jknielse/NixieClock/NixieMicrocontrollerBoard/ArduinoPinMapping.txt

GPS:
8 - TX
9 - RX

SD:
1 - MISO
2 - SCK
3 - MOSI
4 - CS

Nixie:
5 - PROP
6 - CLK
7 - DATA
