jknielse/NixieClock/(list of files, drawings)

Other design files:
NixieDisplayBoard/NixieDisplayBoard.dsn
NixieDriverBoard/NixieDriverBoard.dsn
NixieMicrocontrollerBoard/NixieMicrocontrollerBoard.dsn
