jknielse/NixieClock/NixieMicrocontrollerBoard/NixieMicrocontrollerBoard.kicad_pcb

## KiCad design NixieMicrocontrollerBoard/NixieMicrocontrollerBoard.kicad_pcb (2016-02-14)

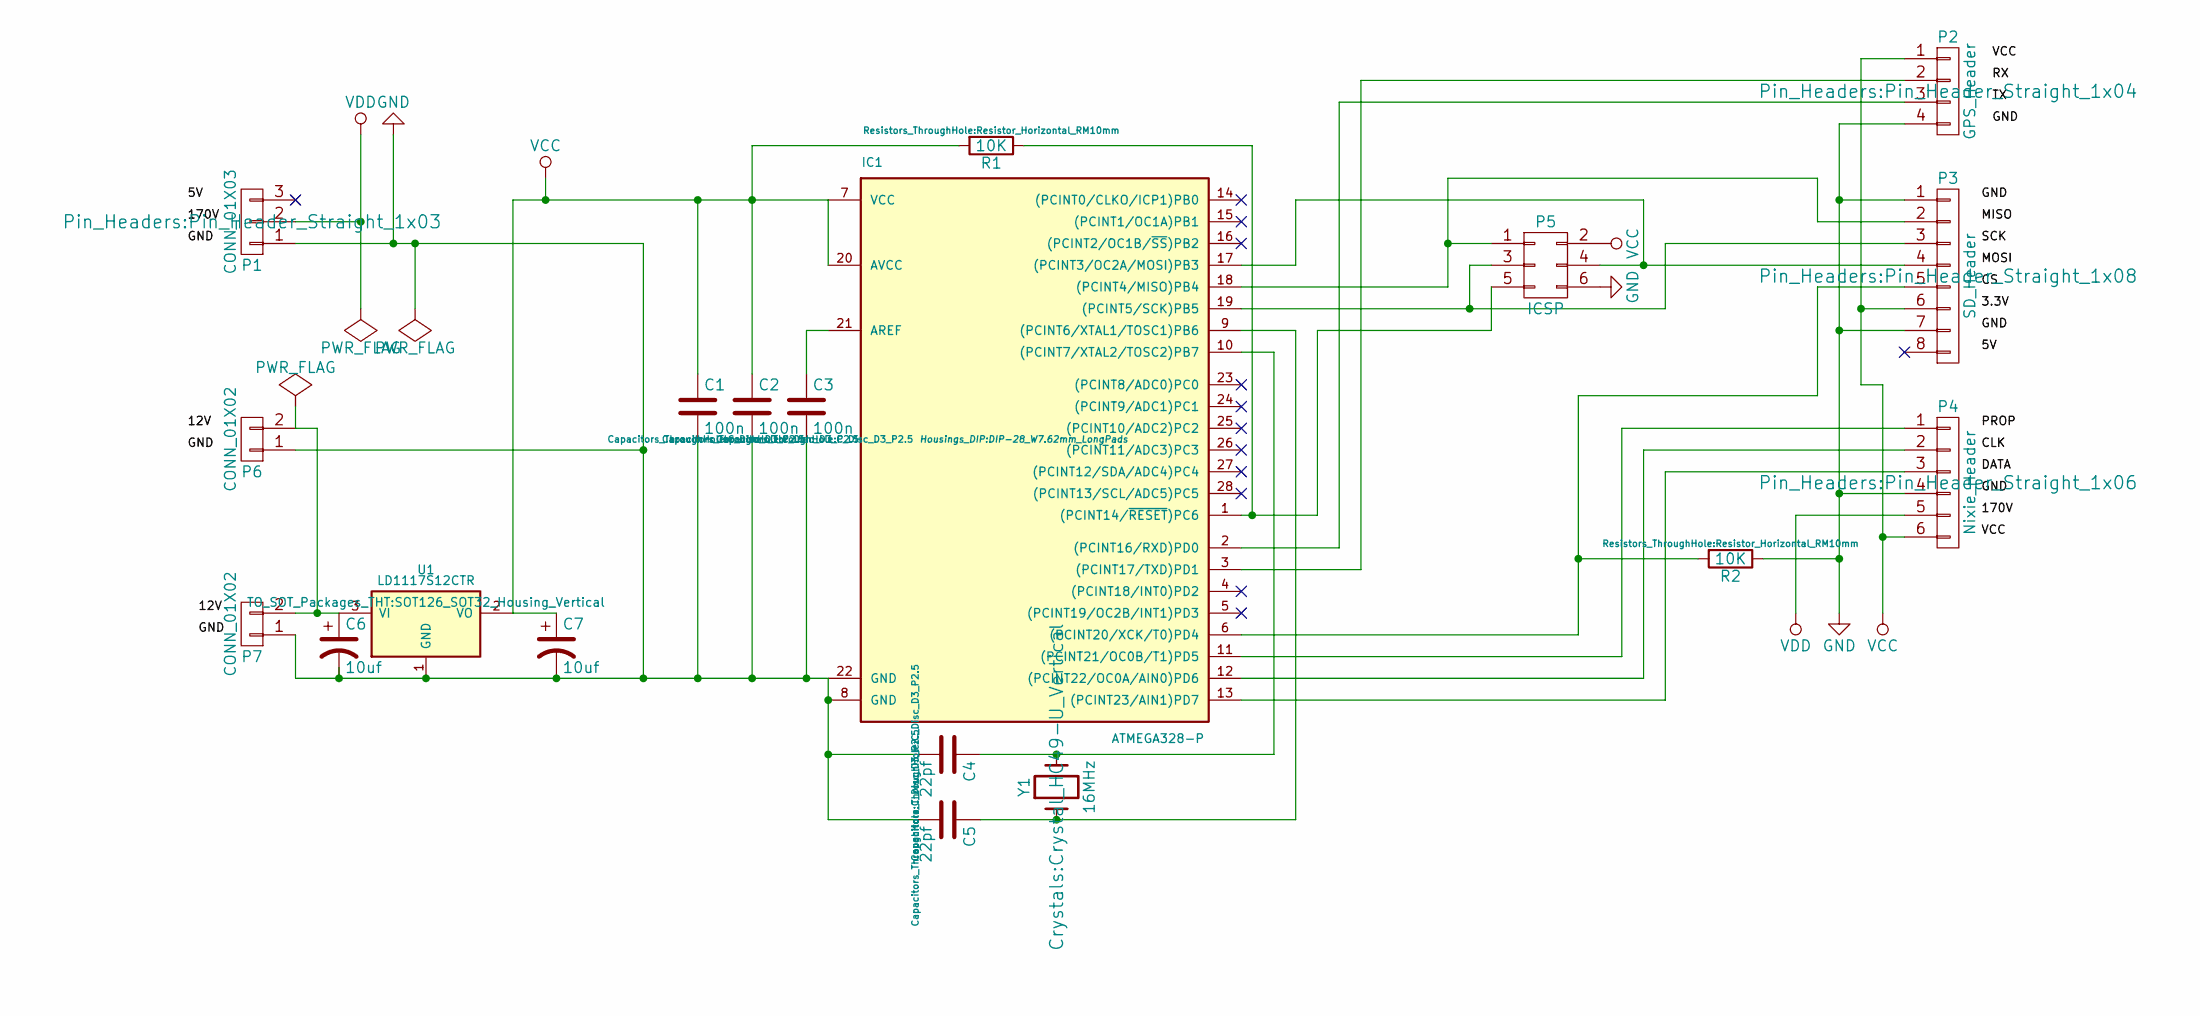
[picture p1: schematic NixieMicrocontrollerBoard.sch]

Parts:
C1, C2, C3: 100n; C_Disc_D3_P2.5
C4, C5: 22pf; C_Disc_D3_P2.5
C6, C7: 10uf; C_Radial_D5_L11_P2.5
IC1: ATMEGA328-P; DIP-28_W7.62mm_LongPads
P1: CONN_01X03; Pin_Header_Straight_1x03
P2: GPS_Header; Pin_Header_Straight_1x04
P3: SD_Header; Pin_Header_Straight_1x08
P4: Nixie_Header; Pin_Header_Straight_1x06
P5: ICSP; Pin_Header_Straight_2x03
P6, P7: CONN_01X02; Pin_Header_Straight_1x02
R1, R2: 10K; Resistor_Horizontal_RM10mm
U1: LD1117S12CTR; SOT126_SOT32_Housing_Vertical
Y1: 16MHz; Crystal_HC49-U_Vertical

Connections:
GND: C1.2, C2.2, C3.2, C4.2, C5.2, C6.2, C7.2, IC1.8 (GND), IC1.22 (GND), P1.1, P2.4, P3.1, P3.7, P4.4, P5.6, P6.1, P7.1, R2.1, U1.1 (GND)
unnamed: C3.1, IC1.21 (AREF)
unnamed: C4.1, IC1.10 ((PCINT7/XTAL2/TOSC2)PB7), Y1.2
unnamed: C5.1, IC1.9 ((PCINT6/XTAL1/TOSC1)PB6), Y1.1
unnamed: C6.1, P6.2, P7.2, U1.3 (VI)
unnamed: IC1.1 ((PCINT14/~RESET~)PC6), P5.5, R1.1
unnamed: IC1.2 ((PCINT16/RXD)PD0), P2.3
unnamed: IC1.3 ((PCINT17/TXD)PD1), P2.2
unnamed: IC1.6 ((PCINT20/XCK/T0)PD4), P3.5, R2.2
unnamed: IC1.11 ((PCINT21/OC0B/T1)PD5), P4.1
unnamed: IC1.12 ((PCINT22/OC0A/AIN0)PD6), P4.2
unnamed: IC1.13 ((PCINT23/AIN1)PD7), P4.3
unnamed: IC1.17 ((PCINT3/OC2A/MOSI)PB3), P3.4, P5.4
unnamed: IC1.18 ((PCINT4/MISO)PB4), P3.2, P5.1
unnamed: IC1.19 ((PCINT5/SCK)PB5), P3.3, P5.3
VCC: C1.1, C2.1, C7.1, IC1.7 (VCC), IC1.20 (AVCC), P2.1, P3.6, P4.6, P5.2, R1.2, U1.2 (VO)
VDD: P1.2, P4.5

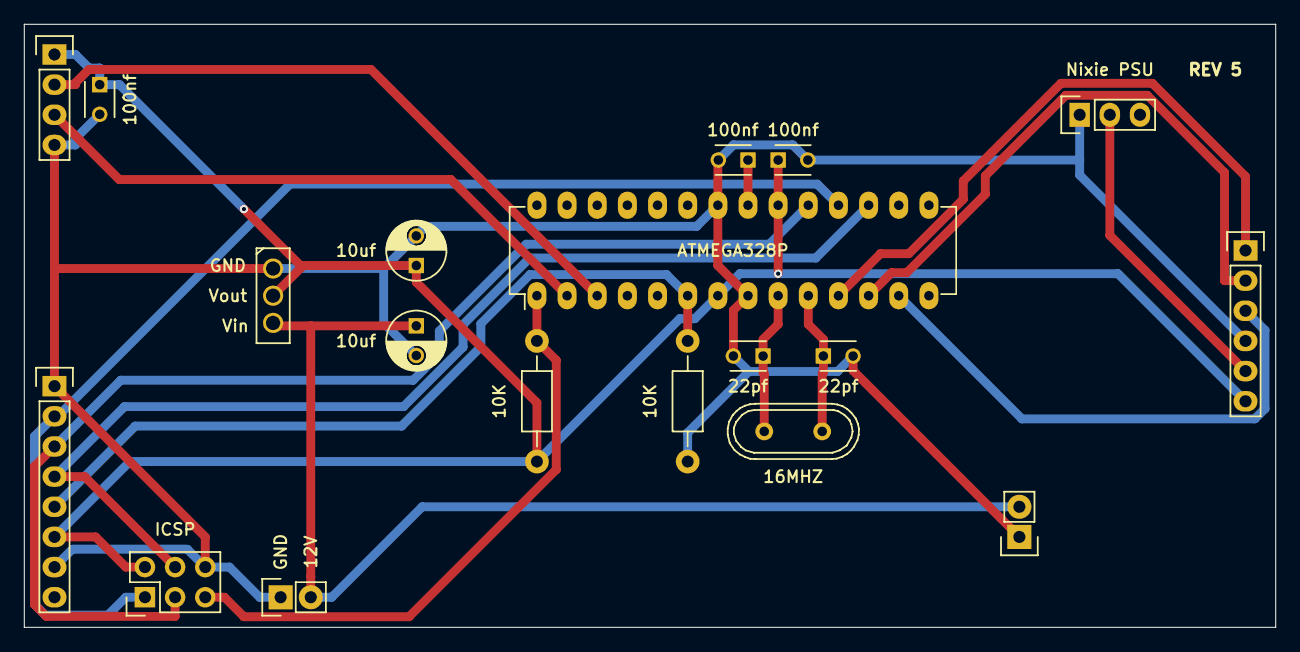
[picture p2: board NixieMicrocontrollerBoard.kicad_pcb from above]

Board: 2 copper layers, 105.4 x 50.8 mm, 19 parts (0 on the bottom side), 17 nets.
