jknielse/NixieClock/NixieDisplayBoard/NixieDisplayBoard.kicad_pcb

## KiCad design NixieDisplayBoard/NixieDisplayBoard.kicad_pcb (2015-11-25)

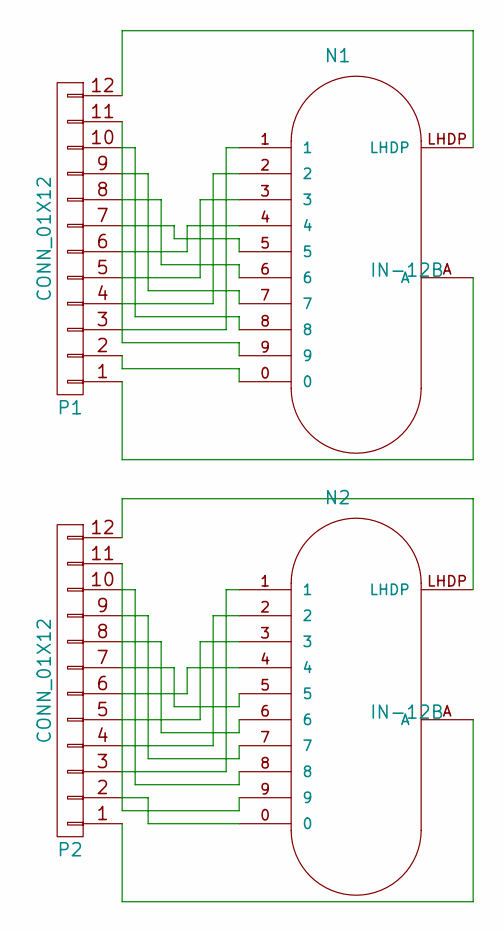
[picture p3: schematic NixieDisplayBoard.sch]

Parts:
N1, N2: IN-12B; russian-nixies-IN-12
P1, P2: CONN_01X12; Pin_Header_Straight_1x12

Connections:
unnamed: N1.0, P1.2
unnamed: N1.1, P1.3
unnamed: N1.2, P1.4
unnamed: N1.3, P1.5
unnamed: N1.4, P1.6
unnamed: N1.5, P1.7
unnamed: N1.6, P1.8
unnamed: N1.7, P1.9
unnamed: N1.8, P1.10
unnamed: N1.9, P1.11
unnamed: N1.A, P1.1
unnamed: N1.LHDP, P1.12
unnamed: N2.0, P2.2
unnamed: N2.1, P2.3
unnamed: N2.2, P2.4
unnamed: N2.3, P2.5
unnamed: N2.4, P2.6
unnamed: N2.5, P2.7
unnamed: N2.6, P2.8
unnamed: N2.7, P2.9
unnamed: N2.8, P2.10
unnamed: N2.9, P2.11
unnamed: N2.A, P2.1
unnamed: N2.LHDP, P2.12

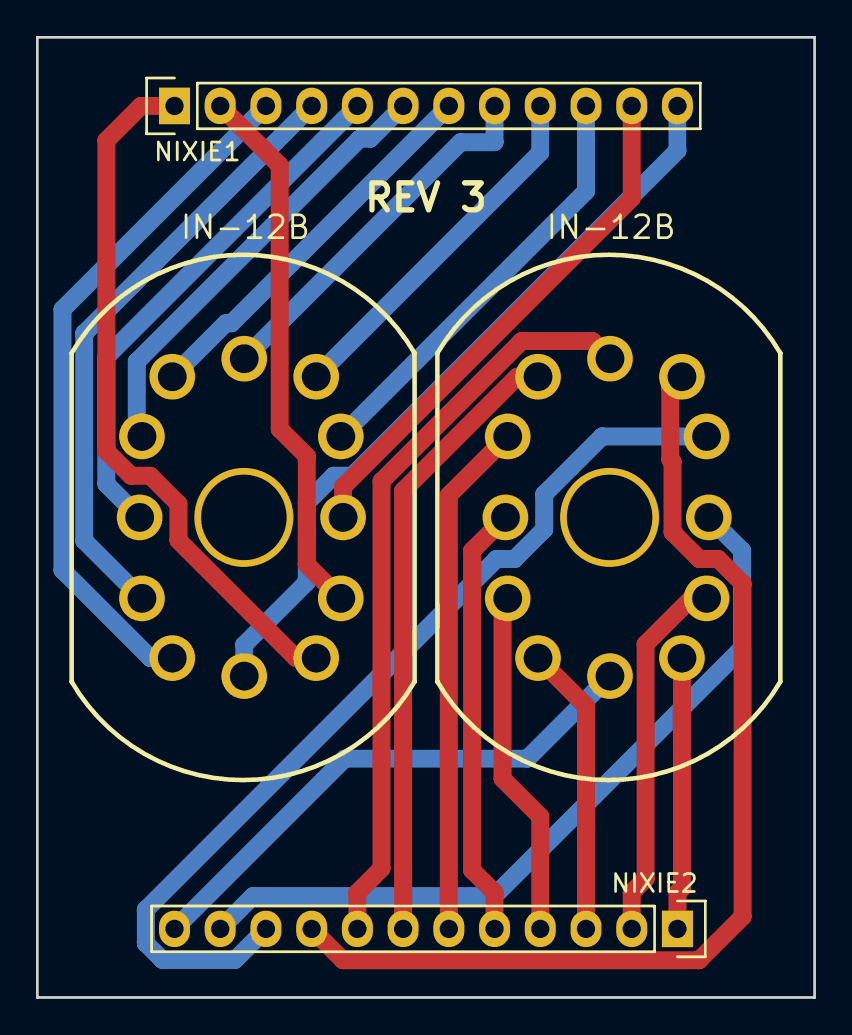
[picture p4: board NixieDisplayBoard.kicad_pcb from above]

Board: 2 copper layers, 43.2 x 53.3 mm, 4 parts (0 on the bottom side), 24 nets.
