jknielse/NixieClock/NixieDriverBoard/NixieDriverBoard.kicad_pcb

## KiCad design NixieDriverBoard/NixieDriverBoard.kicad_pcb (2015-11-25)

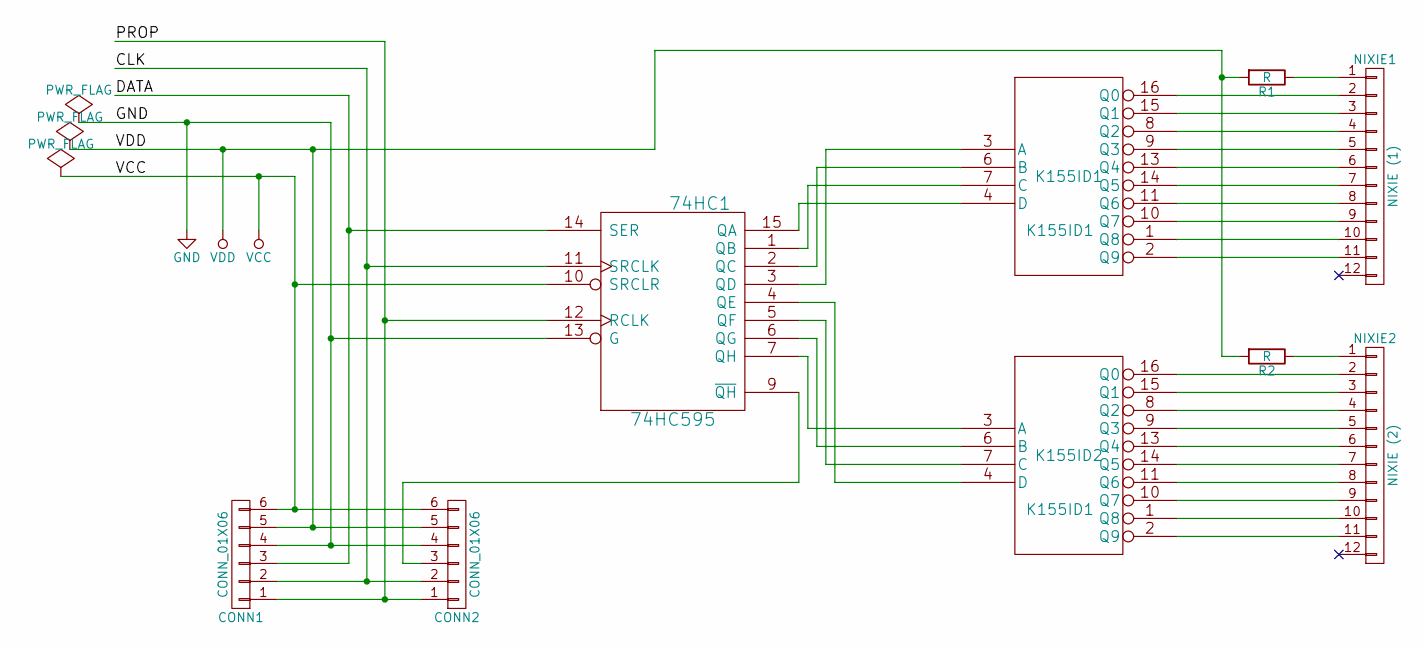
[picture p5: schematic NixieDriverBoard.sch]

Parts:
74HC1: 74HC595; DIP-16_W7.62mm_LongPads
CONN1, CONN2: CONN_01X06; Socket_Strip_Angled_1x06
K155ID1, K155ID2: K155ID1; DIP-16_W7.62mm_LongPads
NIXIE1: NIXIE (1); Socket_Strip_Straight_1x12
NIXIE2: NIXIE (2); Socket_Strip_Straight_1x12
R1, R2: R; Resistor_Horizontal_RM15mm

Connections:
/CLK: 74HC1.11 (SRCLK), CONN1.2, CONN2.2
/DATA: 74HC1.14 (SER), CONN1.3
/PROP: 74HC1.12 (RCLK), CONN1.1, CONN2.1
GND: 74HC1.8 (GND), 74HC1.13 (G), CONN1.4, CONN2.4, K155ID1.12 (GND), K155ID2.12 (GND)
unnamed: 74HC1.1 (QB), K155ID1.7 (C)
unnamed: 74HC1.2 (QC), K155ID1.6 (B)
unnamed: 74HC1.3 (QD), K155ID1.3 (A)
unnamed: 74HC1.4 (QE), K155ID2.4 (D)
unnamed: 74HC1.5 (QF), K155ID2.7 (C)
unnamed: 74HC1.6 (QG), K155ID2.6 (B)
unnamed: 74HC1.7 (QH), K155ID2.3 (A)
unnamed: 74HC1.9 (~QH), CONN2.3
unnamed: 74HC1.15 (QA), K155ID1.4 (D)
unnamed: K155ID1.1 (Q8), NIXIE1.10
unnamed: K155ID1.2 (Q9), NIXIE1.11
unnamed: K155ID1.8 (Q2), NIXIE1.4
unnamed: K155ID1.9 (Q3), NIXIE1.5
unnamed: K155ID1.10 (Q7), NIXIE1.9
unnamed: K155ID1.11 (Q6), NIXIE1.8
unnamed: K155ID1.13 (Q4), NIXIE1.6
unnamed: K155ID1.14 (Q5), NIXIE1.7
unnamed: K155ID1.15 (Q1), NIXIE1.3
unnamed: K155ID1.16 (Q0), NIXIE1.2
unnamed: K155ID2.1 (Q8), NIXIE2.10
unnamed: K155ID2.2 (Q9), NIXIE2.11
unnamed: K155ID2.8 (Q2), NIXIE2.4
unnamed: K155ID2.9 (Q3), NIXIE2.5
unnamed: K155ID2.10 (Q7), NIXIE2.9
unnamed: K155ID2.11 (Q6), NIXIE2.8
unnamed: K155ID2.13 (Q4), NIXIE2.6
unnamed: K155ID2.14 (Q5), NIXIE2.7
unnamed: K155ID2.15 (Q1), NIXIE2.3
unnamed: K155ID2.16 (Q0), NIXIE2.2
unnamed: NIXIE1.1, R1.1
unnamed: NIXIE2.1, R2.1
VCC: 74HC1.10 (SRCLR), 74HC1.16 (VCC), CONN1.6, CONN2.6, K155ID1.5 (VCC), K155ID2.5 (VCC)
VDD: CONN1.5, CONN2.5, R1.2, R2.2

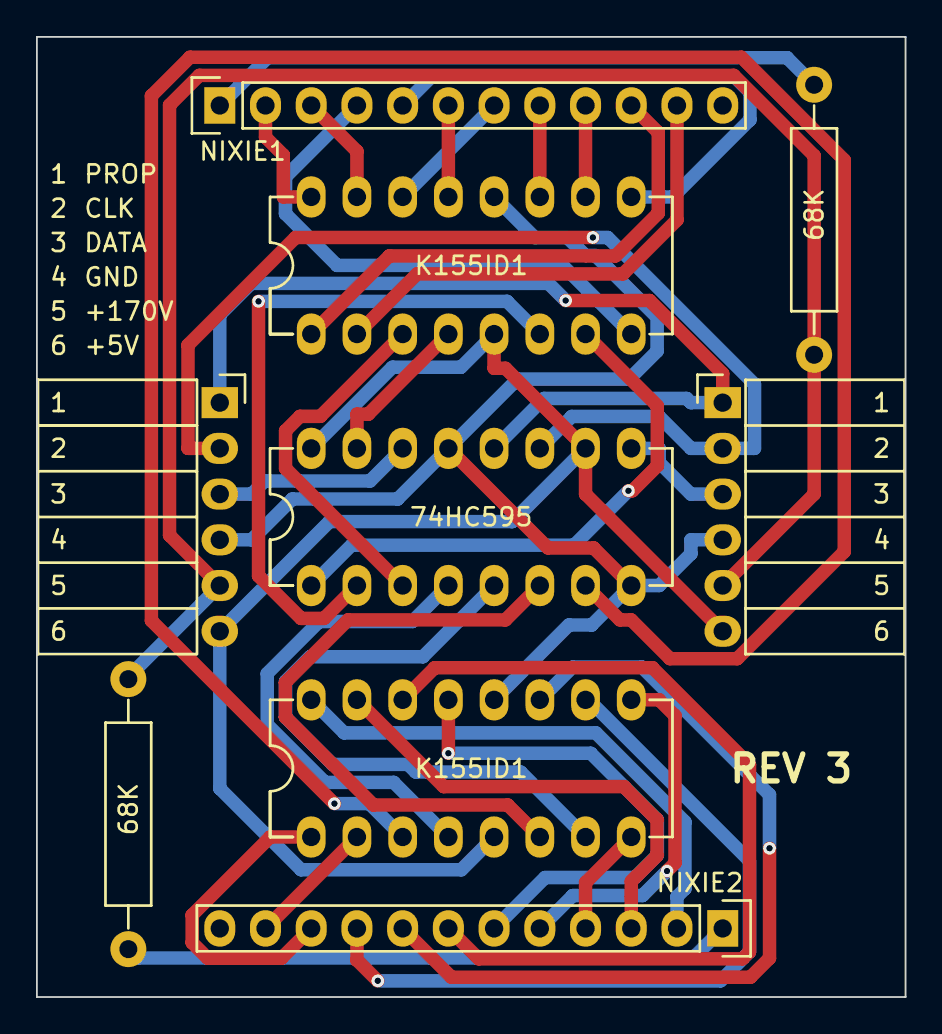
[picture p6: board NixieDriverBoard.kicad_pcb from above]

Board: 2 copper layers, 48.3 x 53.3 mm, 9 parts (1 on the bottom side), 37 nets.
