jknielse/NixieClock/(threads)

Thread 1 (2015-11-21):

DIP socket holes are too small

jknielse, 2015-11-21:
The DIP sockets' holes are smaller than the other holes, and also make it difficult to actually fit the chip legs into the hole.

jknielse, 2015-12-14:
This also got fixed a few commits ago

Closed 2015-12-14.

Thread 2 (2015-11-21):

Make driver boards more intuitive

jknielse, 2015-11-21:
The numbers are sort-of "backwards" right now. in order to say "2", you want to push numbers down the line such that the nixie driver sees 0 0 1 0, but in order to do that, you need to push 0 1 0 0.

jknielse, 2015-12-14:
This got solved a few commits ago

Closed 2015-12-14.

Thread 3 (2015-12-14):

SD card portion of microcontroller board needs a level shifter

jknielse, 2015-12-14:
SD cards operate at 3.3V rather than 5V, so that needs to be taken into account

jknielse, 2015-12-17:
The latest commit includes voltage divider resistors

Closed 2015-12-17.

Thread 6 (2015-12-21):

Account for clock drift in software

jknielse, 2015-12-21:
Although the arduino can roughly keep track of the time during times that it doesn't have a gps signal, the drift is pretty bad. (on the order of 2s per minute). It is possible to have the clock self-calibrate by assessing its own drift against the GPS clock, and adjusting accordingly.

jknielse, 2016-02-07:
Done

Closed 2016-02-07.

Thread 7 (2015-12-22):

Make sure that the internal clock overflow is going to be handled gracefully

jknielse, 2015-12-22:
I haven't thought too hard about it, so let's make sure that when the millis() function overflows we're going to do the right thing.

jknielse, 2016-02-07:
I think this is solved

Closed 2016-02-07.
