jknielse/NixieClock/(commit log)

2015-10-18 Adds nixie tube driver circuit design
    [NixieClock.kicad_pcb, NixieClock.sch]
2015-11-05 Completely overhauls everything
    [NixieClock.kicad_pcb, NixieClock.sch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]
2015-11-05 Updates the display board to center the center-hole
    [NixieDisplayBoard-B.Cu.gbl, NixieDisplayBoard-B.Mask.gbs, NixieDisplayBoard-B.SilkS.gbo, NixieDisplayBoard-Edge.Cuts.gm1, NixieDisplayBoard-F.Cu.gtl, NixieDisplayBoard-F.Mask.gts, NixieDisplayBoard-F.SilkS.gto, NixieDisplayBoard.drl]
2015-11-21 Updates nixie boards
    [NixieDisplayBoard-B.Cu.gbl, NixieDisplayBoard-B.Mask.gbs, NixieDisplayBoard-B.SilkS.gbo, NixieDisplayBoard-Edge.Cuts.gm1, NixieDisplayBoard-F.Cu.gtl, NixieDisplayBoard-F.Mask.gts, NixieDisplayBoard-F.SilkS.gto, NixieDisplayBoard.drl]
2015-11-21 Makes the nixie breakout board less stupid about which pins mean what...
    [NixieDisplayBoard-B.Cu.gbl, NixieDisplayBoard-B.Mask.gbs, NixieDisplayBoard-B.SilkS.gbo, NixieDisplayBoard-Edge.Cuts.gm1, NixieDisplayBoard-F.Cu.gtl, NixieDisplayBoard-F.Mask.gts, NixieDisplayBoard-F.SilkS.gto, NixieDisplayBoard.drl]
2015-11-25 Makes driver board more intuitive, and cleans up the silkscreen layers on both boards
    [NixieDisplayBoard.kicad_pcb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]
2015-12-02 Completes the microcontroller board
    [NixieMicrocontrollerBoard-B.Cu.gbl, NixieMicrocontrollerBoard-B.Mask.gbs, NixieMicrocontrollerBoard-B.SilkS.gbo, NixieMicrocontrollerBoard-Edge.Cuts.gm1, NixieMicrocontrollerBoard-F.Cu.gtl, NixieMicrocontrollerBoard-F.Mask.gts, NixieMicrocontrollerBoard-F.SilkS.gto, NixieMicrocontrollerBoard.drl]
2015-12-17 Fixes up the microcontroller board, and adds a library to drive the Nixie boards
    [NixieMicrocontrollerBoard-B.Cu.gbl, NixieMicrocontrollerBoard-B.Mask.gbs, NixieMicrocontrollerBoard-B.SilkS.gbo, NixieMicrocontrollerBoard-Edge.Cuts.gm1, NixieMicrocontrollerBoard-F.Cu.gtl, NixieMicrocontrollerBoard-F.Mask.gts, NixieMicrocontrollerBoard-F.SilkS.gto, NixieMicrocontrollerBoard.drl]
2015-12-23 Fixes the SD card pin connections to use the SPI bus
    [NixieMicrocontrollerBoard.sch]
2016-02-06 Updates the board schematic after doing some breadboarding.. Does *not* update the gerber files
    [_saved_NixieMicrocontrollerBoard.sch]
2016-02-07 Gets the sd card stuff mostly working
    [NixieMicrocontrollerBoard.sch, _saved_NixieMicrocontrollerBoard.sch]
2016-02-08 Adds interrupt functionality
2016-02-13 Drives the clock off of serial interrupts
2016-02-14 Makes interrupts smarter by only triggering them once per second, and tweaks the waiting animation
2016-02-14 Updates NixieMicrocontrollerBoard to include power circuits, and all of the changes I made to the breadboarded circuit yesterday
    [NixieMicrocontrollerBoard-B.Cu.gbl, NixieMicrocontrollerBoard-B.Mask.gbs, NixieMicrocontrollerBoard-B.SilkS.gbo, NixieMicrocontrollerBoard-Edge.Cuts.gm1, NixieMicrocontrollerBoard-F.Cu.gtl, NixieMicrocontrollerBoard-F.Mask.gts, NixieMicrocontrollerBoard-F.SilkS.gto, NixieMicrocontrollerBoard.drl]
2016-02-14 Makes the board more heatsink-friendly
    [NixieMicrocontrollerBoard-B.Cu.gbl, NixieMicrocontrollerBoard-B.Mask.gbs, NixieMicrocontrollerBoard-B.SilkS.gbo, NixieMicrocontrollerBoard-Edge.Cuts.gm1, NixieMicrocontrollerBoard-F.Cu.gtl, NixieMicrocontrollerBoard-F.Mask.gts, NixieMicrocontrollerBoard-F.SilkS.gto, NixieMicrocontrollerBoard.drl]
2016-02-18 Removes buggy-ass arduino strings
    [NixieSketch.ino]
2016-02-18 Fixes types in ClockTime::unixTime
    [ClockTime.cpp]
2016-03-27 Finally fixed the bug
    [NixieSketch.ino, NixieTubeTest.ino]
2020-04-26 Removes dependency on manual interrupt registration
